M-nohira/NixieTubeClock/説明書A5.pdf

Nixie module ver.1/6digit model Clock Logic Module Ver.1
Clock Logic Module Ver_1.1

# ニキシー管時計

+α

注意事項 p.1 | ⽬次 p.2
1. この説明書に書かれている内容は、のちに変更される可能性があります
2. 説明書によって発⽣した損害については⼀切責任を負いません
3. この説明書が解説しているモジュールは Nixie Module Ver.1_6digit model, Clock Module Ver.1 のみです
4. ⾼電圧(約200V)を扱うため絶縁, その他感電を防ぐ⾏動を⼼がけてください

# 注意事項

目次

注意事項 | 1
目次 | 2
前書き | 3
パーツリスト | 4
回路図 | 7
パターン図 | 9
修正方法 | 11
その他 | 12
最後に | 14

# 前書き

# パーツリスト

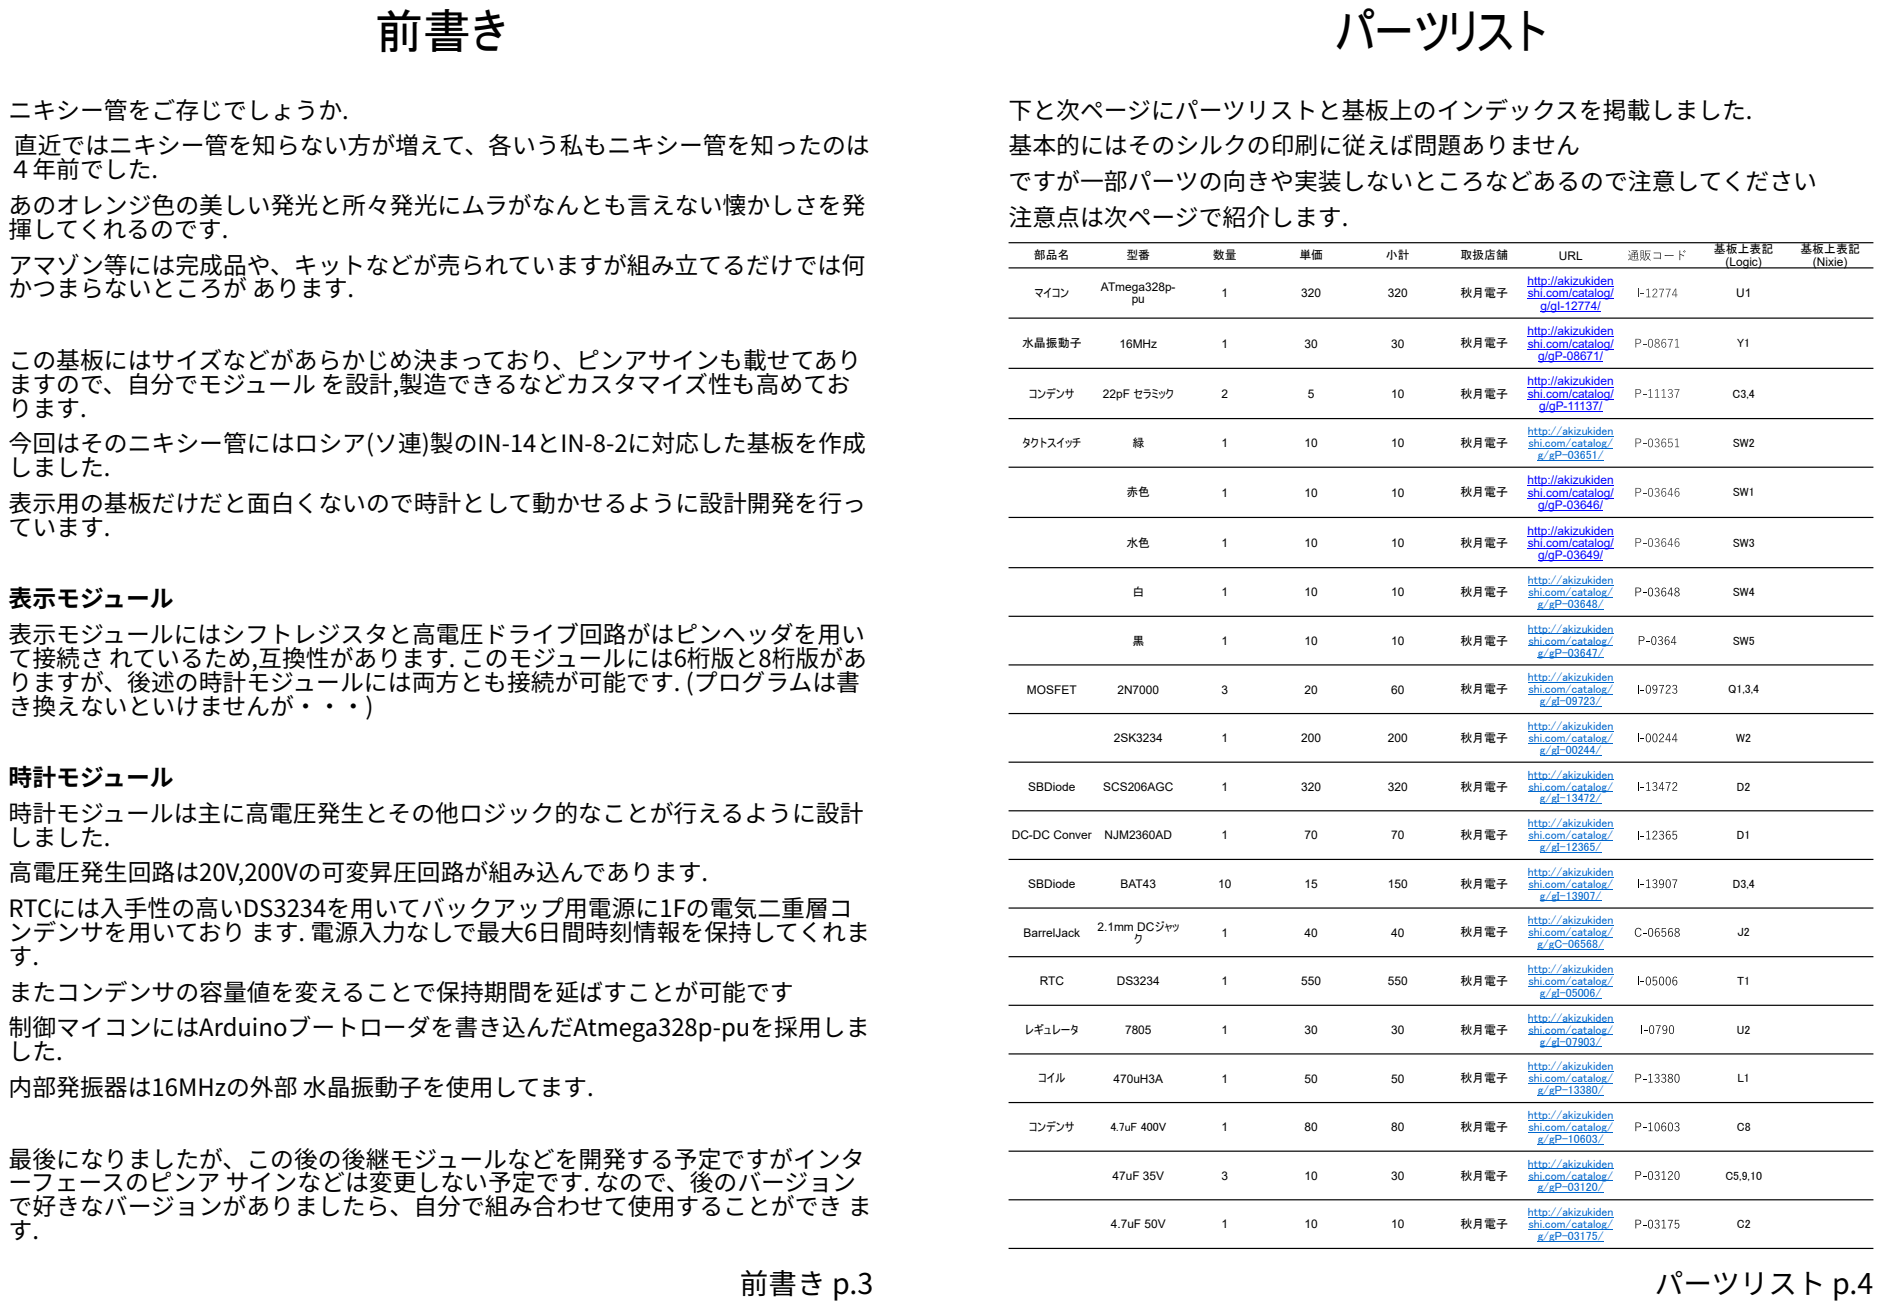
[picture p1: page 3]

この基板にはサイズなどがあらかじめ決まっており、ピンアサインも載せてあり
ますので、⾃分でモジュール を設計,製造できるなどカスタマイズ性も⾼めてお
ります.
今回はそのニキシー管にはロシア(ソ連)製のIN-14とIN-8-2に対応した基板を作成
しました.
表⽰⽤の基板だけだと⾯⽩くないので時計として動かせるように設計開発を⾏っ
ています.

表⽰モジュール
表⽰モジュールにはシフトレジスタと⾼電圧ドライブ回路がはピンヘッダを⽤い
て接続さ れているため,互換性があります. このモジュールには6桁版と8桁版があ
りますが、後述の時計モジュールには両⽅とも接続が可能です. (プログラムは書
き換えないといけませんが‧‧‧)

時計モジュール
時計モジュールは主に⾼電圧発⽣とその他ロジック的なことが⾏えるように設計
⾼電圧発⽣回路は20V,200Vの可変昇圧回路が組み込んであります.
RTCには⼊⼿性の⾼いDS3234を⽤いてバックアップ⽤電源に1Fの電気⼆重層コ
ンデンサを⽤いており ます. 電源⼊⼒なしで最⼤6⽇間時刻情報を保持してくれま
またコンデンサの容量値を変えることで保持期間を延ばすことが可能です
制御マイコンにはArduinoブートローダを書き込んだAtmega328p-puを採⽤しま
内部発振器は16MHzの外部 ⽔晶振動⼦を使⽤してます.

最後になりましたが、この後の後継モジュールなどを開発する予定ですがインタ
ーフェースのピンア サインなどは変更しない予定です. なので、後のバージョン
で好きなバージョンがありましたら、⾃分で組み合わせて使⽤することができ ま

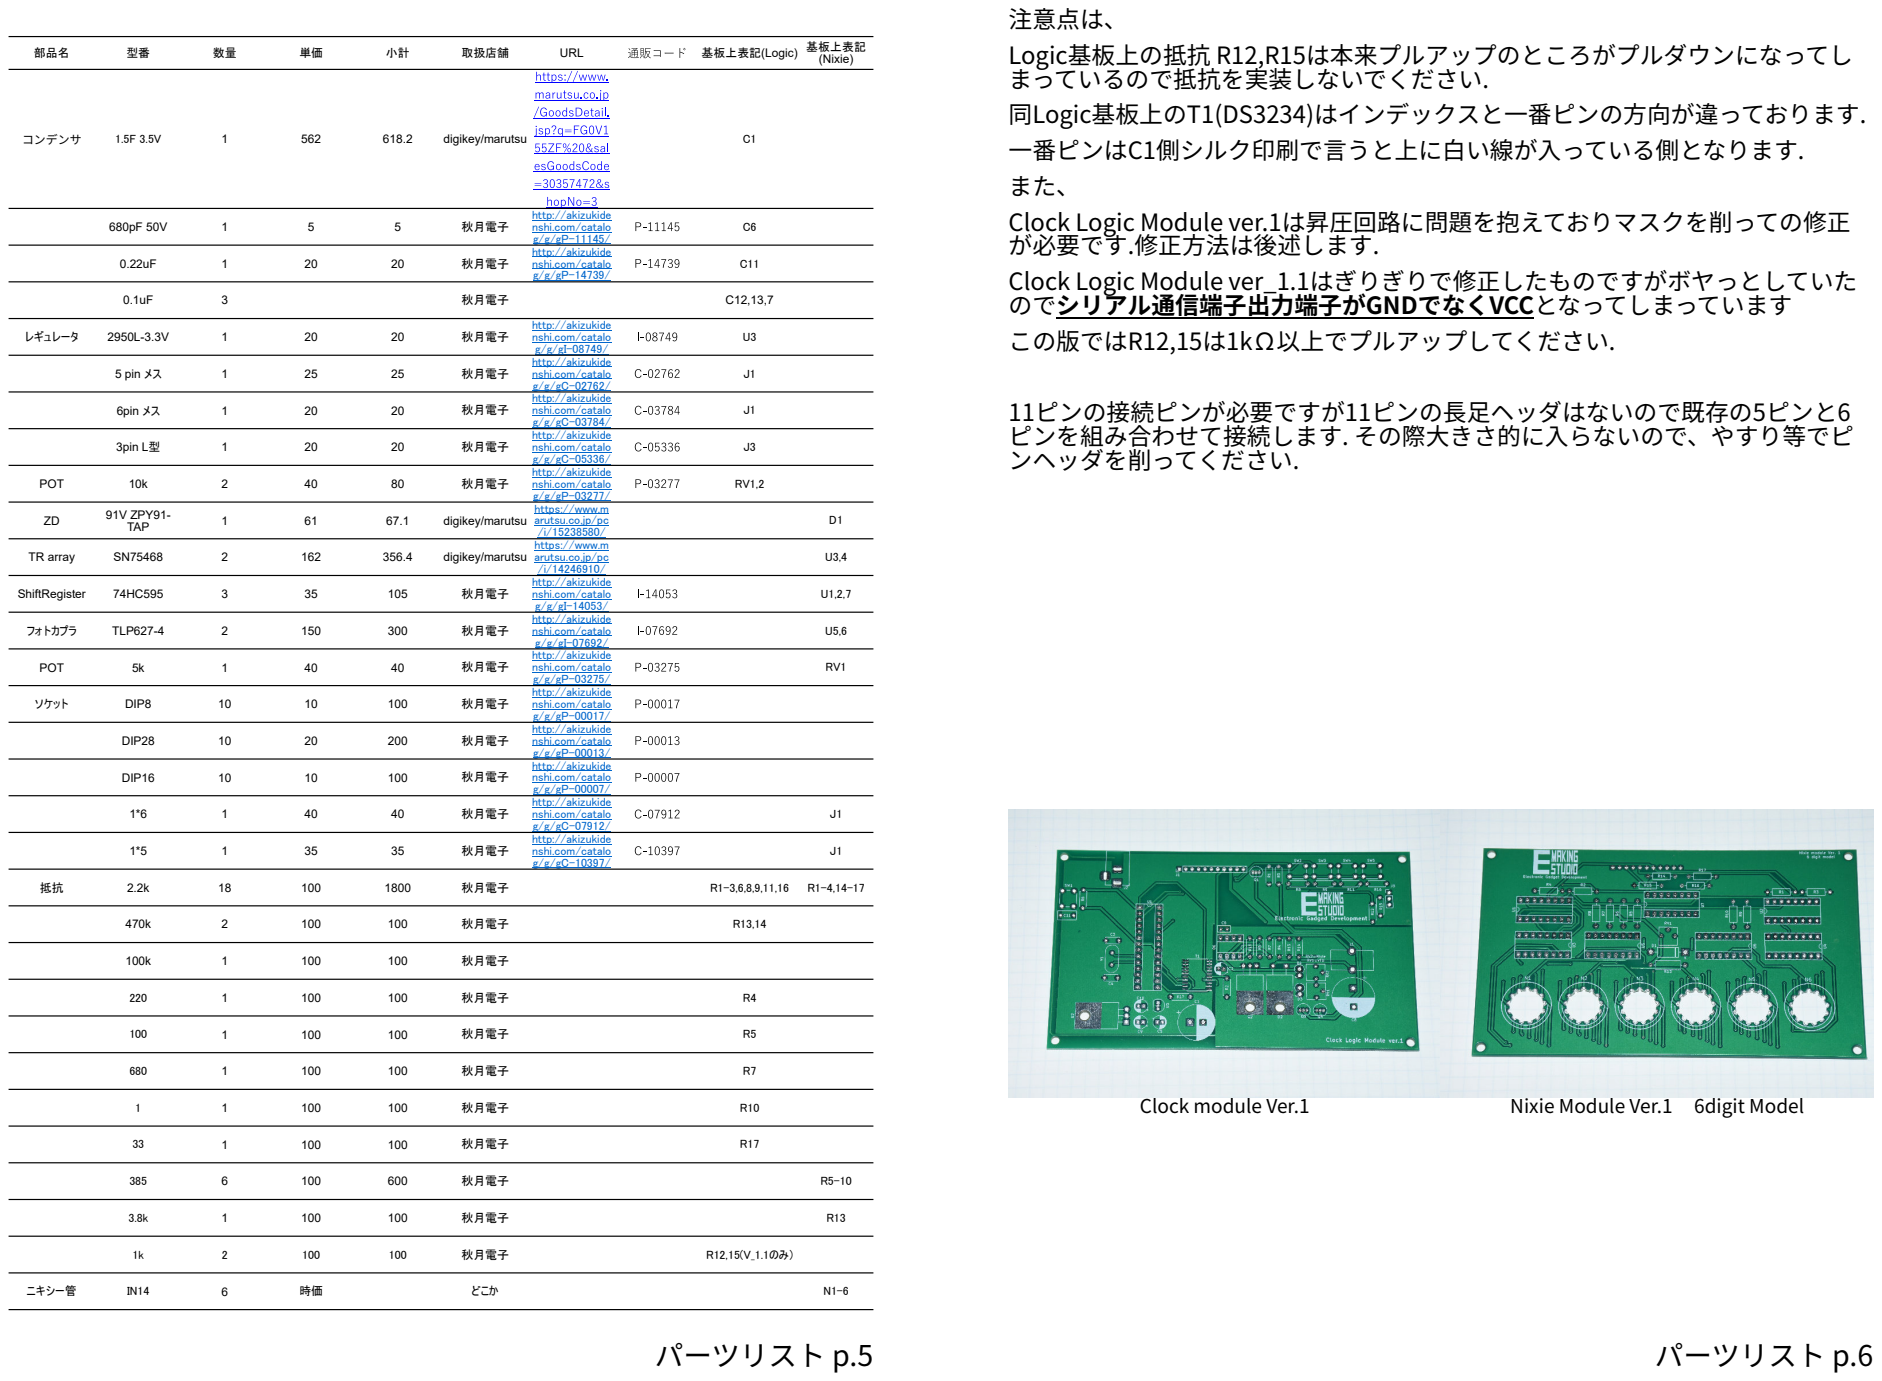
[picture p2: page 4]

注意点は、
Logic基板上の抵抗 R12,R15は本来プルアップのところがプルダウンになってし
まっているので抵抗を実装しないでください.
同Logic基板上のT1(DS3234)はインデックスと⼀番ピンの⽅向が違っております.
⼀番ピンはC1側シルク印刷で⾔うと上に⽩い線が⼊っている側となります.
Clock Logic Module ver.1は昇圧回路に問題を抱えておりマスクを削っての修正
が必要です.修正⽅法は後述します.
Clock Logic Module ver_1.1はぎりぎりで修正したものですがボヤっとしていた
のでシリアル通信端⼦出⼒端⼦がGNDでなくVCCとなってしまっています
この版ではR12,15は1kΩ以上でプルアップしてください.

http://akizukide
nshi.com/catalo
https://www.m
arutsu.co.jp/pc

11ピンの接続ピンが必要ですが11ピンの⻑⾜ヘッダはないので既存の5ピンと6
ピンを組み合わせて接続します. その際⼤きさ的に⼊らないので、やすり等でピ
ンヘッダを削ってください.

# 回路図

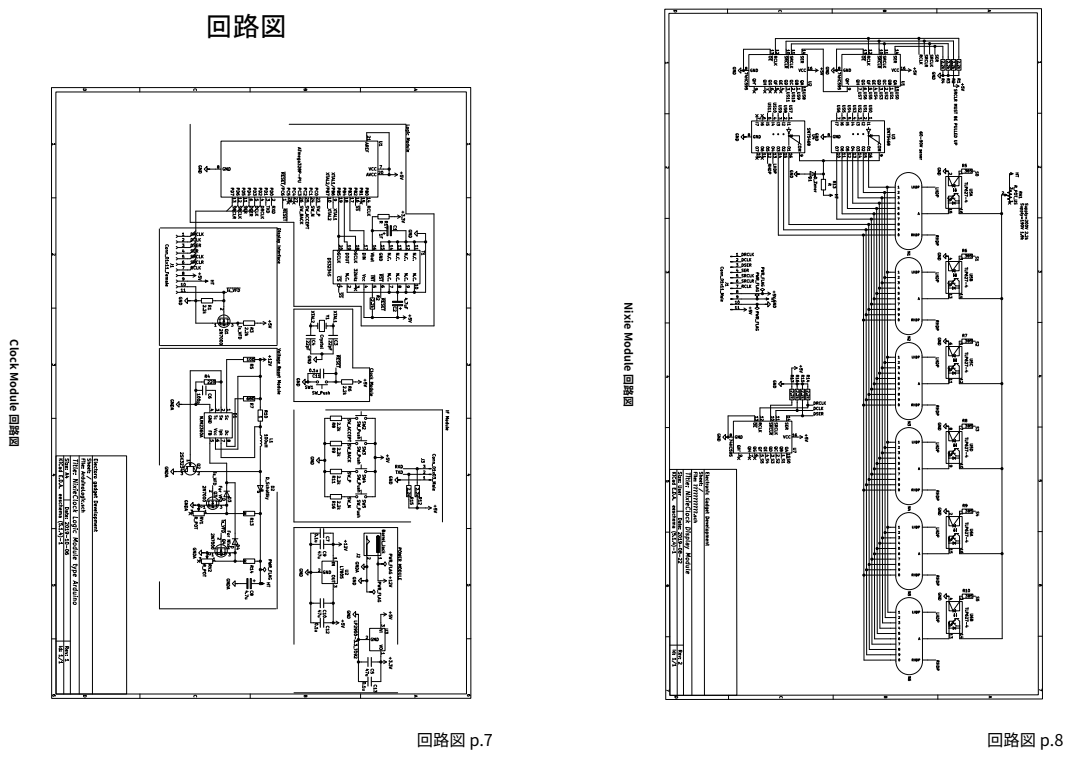
[picture p3: page 5]
回路図 p.7; 回路図 p.8

Nixie Module 回路図

Clock Module 回路図

# パターン図

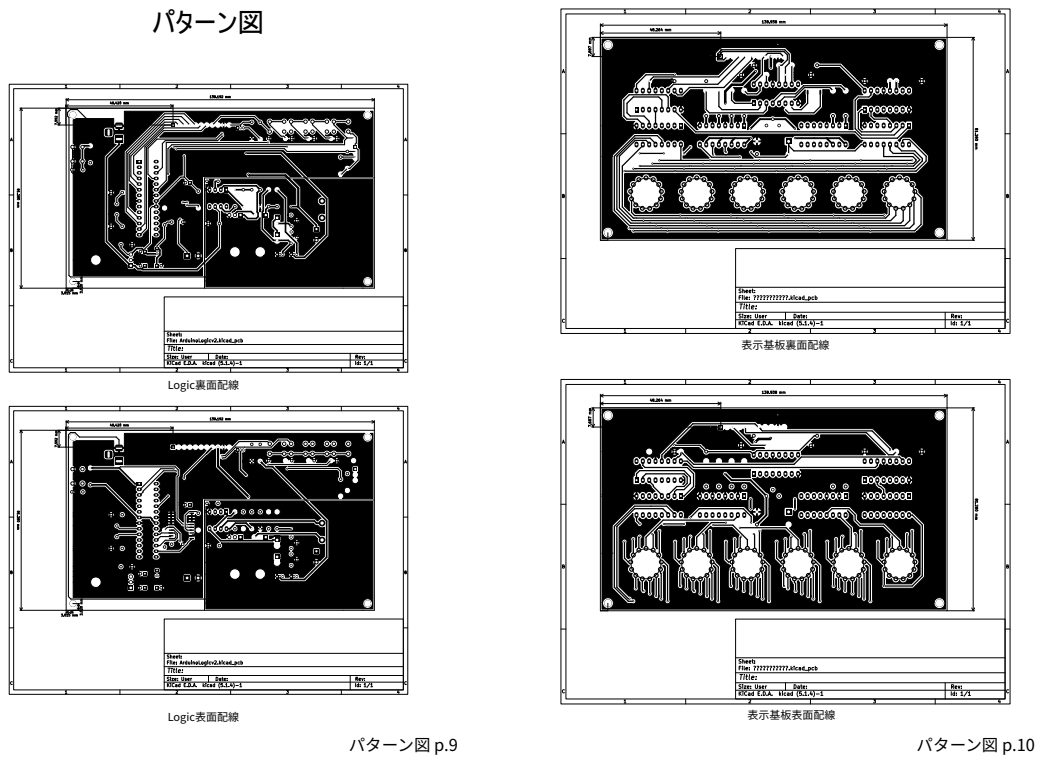
[picture p4: page 6]
パターン図 p.9; パターン図 p.10; Logic裏⾯配線; 表⽰基板裏⾯配線; Logic表⾯配線; 表⽰基板表⾯配線

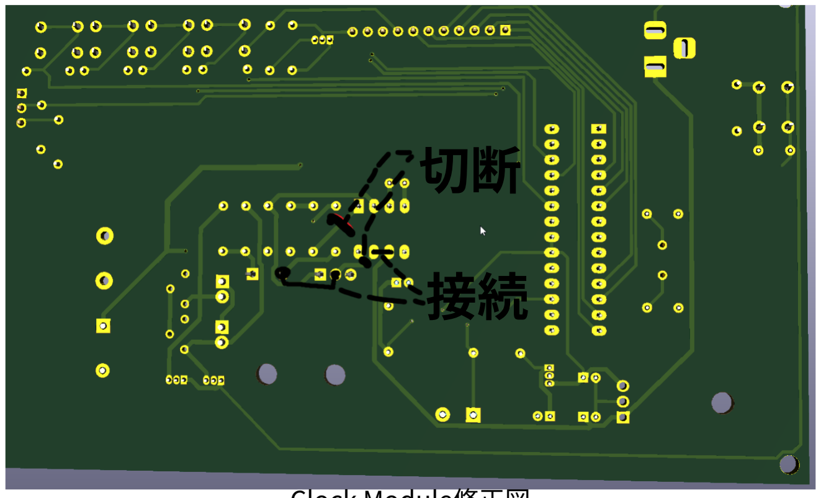
[picture p5: figure]

修正⽅法 p.11 | その他 p.12

# 修正方法

この章では前述したClockModule ver.1の修正⽅法を紹介します. ClockModuleの昇圧回路にはうまく昇圧できない問題が発⽣しております 配線を2本削りかつジャンパーを数本渡します.

D1の７番ピンから伸びる配線をマイナスドライバなどで削って切断します. 切断後、隣の6番ピンと接続します.
またR10のスイッチ側から伸びる配線を切断します.
切断後、Q1の２番ピン(ドレイン)とD2のアノードとを接続します. D2の放熱ランド⾯を耐熱ポリイミドテープで保護します. なお保護しない場合ショート状態となりうまく昇圧されません.

Clock Module修正図
線路に対して垂直に線が引かれていると切断

# その他

今回は中華の基板製作業者のElecrowに発注しました. Elecrowには⽇本への宅配オプションにOCS/ANA Expressオプションがあ るので、安価に⽇本へ送ることができます.
シルクの印刷精度や、その他基板加⼯精度は申し分ないほどに⾼いです. また、製造終了後に商品と送り状の写真を添付してメールで送ってくれま す.

基板発注について

管⾃体の購⼊にはwww.nixie-tube.comにて発注するのが簡単なのですが 如何せん使⽤する予定の管が売り切れてしまっています. そこで、リトアニアの業者であるtubehobby.comに発注するのが現状楽 ではあります.
発注⽅法が特殊で、サイト管理者とメールで直接やり取りしてどの管が どのくらい必要なのかを知らせる必要があります.
なので、英語でのやり取りが苦⼿な⼈はamazonやebay等を巡回するこ とをお勧めします.

ニキシー管購⼊について

私は回路設計ソフトにはKicadを⽤いて設計しております. それ⾃体にはEagleのような⾃動配線機能はありませんが無料で設計可能 サイズ無制限という利点があります.(オープンソースなので当然ですが) 外部機能にて⾃動配線機能を使⽤することができます.
Elecrowに発注するときは”Postelの拡張⼦を使⽤する”項⽬にチェックを ⼊れると対応した拡張⼦で出⼒されます.

回路設計ソフト

昇圧回路にはDC-DcのNJM2360ADを使⽤した単純なものになっておりま す.
駆動回路は⾼耐圧トランジスアレイであるSN75468を使⽤してCC端⼦に 91Vのツェナーダイオードを使⽤してニキシー管を駆動しております. アノード側はTLP627-4を使⽤しております. このフォトカプラの動作電圧 や、動作速度等を⾒るとニキシー管を駆動するために⽣まれてきたのでは と思うほどピッタリのフォトカプラです.
もともとこの基板は8桁で製作されていましたが、８本のニキシー管を使 ⽤するとなると管代だけで⾼額になってしまうので６桁に変更いたしま した.
基本設計は全く同じなので後⽇何かしらの形で頒布する予定です. 上の基板も同じ仕様で設計されているので今回の時計基板を使ってドラ イブさせることも可能です.

ニキシー管の駆動と基板

その他 p.13 | 最後に p.14

仕様的には上のモジュールをVFDに変更することが可能です. 昇圧回路にロジックを搭載しており190V⇔20Vの切り替えが可能です. 切り替えですが、上のモジュールの種類によって切り替わるように設計し ております. 回路図を⾒るとわかるのですが、11番ピンに”is_VFD”を参 照してロジックが切り替わるようになっています.
なお、下の時計基板でプルダウンされていますので駆動基板側ではただピ ンを11につなぐだけで問題ありません.

# 最後に

コミケ初参加のサークルですが購⼊いただきありがとうございます. この説明書的な何かしらは現在のところネット配布は考えておりません. この初版ははんだ付けの基礎や、その他定⽯などの紹介が無い為、電⼦⼯作初⼼ 者には厳しくなっております.
パーツ表とそれに対応するシルク印刷が書いてあるだけなので多少難易度は⾼い ですが組み⽴てられないことはないと思います.
ニキシー管は現在供給されていることはされているのですが、その⽣産も少数で あり現在は、その昔のソ連やNEC、東芝が作っていたニキシー管の解体品や余剰 品を消費してつくれられています. 今後ニキシー管⾃体が⼿に⼊らなくなってし まうことは確実です.
個⼈的には、真空管やそのほかのように⼀部のマニア向けに少数⽣産を⾏って遅 れる企業が表れてくれるとうれしいと思いますが期待薄です. レトロでスチームパンクで美しいニキシー管をぜひとも⼀般の⽅々にも気に⼊っ ていただけるような環境があれば多少の需要が⽣まれるのですが‧‧‧. 駆動に⾼電圧(約200V)が必要なうえ管の寿命はさほど⻑くないので廃れる（流⾏ が去る）のは早いと思います.
当⽅にガラス加⼯,⾦属加⼯の技術があれば、管⾃体を作成することも可能ですが 、設備その他にとてもお⾦がかかってしまうので夢のまた夢です. 愚痴をだいぶこぼしてしまいましたが、購⼊いただきありがとうございます まだ初版なので、さほど多くの情報量もなく,ただの説明書程度のにしかなってお りませんが‧‧‧.

時計の⼼臓部ともいえるRTCの選定については時間をかけました(30秒) ⼊⼿性と正確性を換算できるものを選定しました.
⼊⼿性は秋⽉電⼦で購⼊できることを考え、また精度の⾼いものを考えた 結果、DS3234に決定しました.
GPSモジュールも考えたのですが、使⽤する場所がコンクリートジャング ルのど真ん中や、地下であることも考慮すると校正が⾮常に簡単なRTCを 使⽤するという結論になりました.
今後ですが、NTPと通信して同期する時計も考えていたりするので、どう ぞ楽しみにしてください.

RTCについて

基本的にピンアサインとサイズのみの規定となっております. ピンの⼀番ピンの⽳の中⼼から
横に48.26mm 縦に7.684mm になっております. またスペーサ⽤の⽳ですがこれは、
基板の端から中⼼がそれぞれ3mm離れたΦ3mmの⽳になっております.

表⽰基板の規格について

⼈伝⼿に聞いた話ですが、どうやらNutubeなどを⼿掛けている業者に数 千個,数万個単位でなら作ってくれるという情報を聞きました. 単なるうわさ話なのですが、もし本当だったらMAKUAKE等のファンディ ングで資⾦を集めて発注してもよさそうだと思います.

ニキシー管の業者発注
2019/12/31 c97 ⻄す14b
電⼦ガジェット開発局
_N_Magi
