M-nohira/NixieTubeClock/(commit log)

2019-12-31 Add files via upload
    頒布本売り切れに備えて
2020-01-14 ニキシー管表示モジュールのライブラリ RTC用のライブラリ"DS3234"用のものがなかったため
2020-01-14 フォルダ整理と参照の修正
2020-01-18 コード修正ミスの修正
2020-01-18 Revertによる競合の修正
2020-01-20 とりあえずの完成 コンパイラー最適化オプション-O0
2020-01-20 SPI_CLK を 4MHzへ 時計読み出しを0.5秒に一回へ
2020-01-29 ソースコードのお掃除とライブラリ分け
2020-01-30 シリアル設定可能とピン番号修正
